zninjamonkey/starting-clamp/BOM.csv

Item | Qty | Supplier | Cost/item | Total Cost | link
PETG filament | 1 | Bambu Lab | $15.99 | $15.99 | https://us.store.bambulab.com/products/petg-translucent?id=42479468281992
Estimated total shipping | 1 |  |  | $7.97
