zninjamonkey/starting-clamp/step/clamp assembly.step

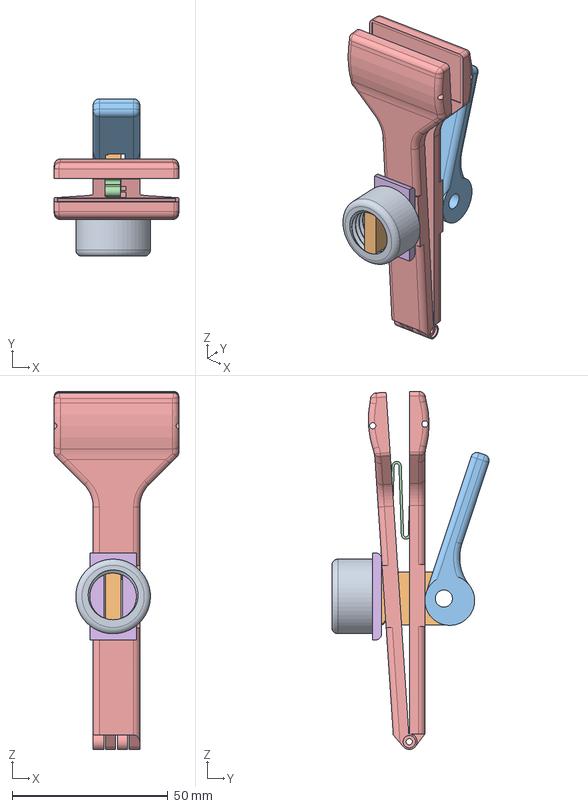
[picture p1: CAD file, 2026-10-17]
step/clamp assembly.step
40.0 x 50.6 x 115.0 mm
