zninjamonkey/starting-clamp/step/clamp spacer.step

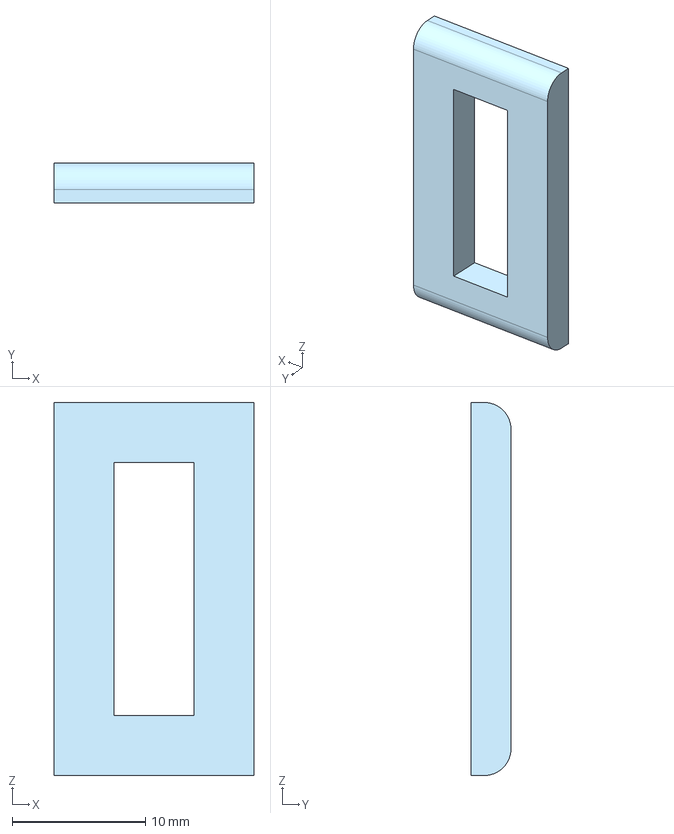
[picture p2: CAD file, 2026-10-17]
step/clamp spacer.step
15.0 x 3.00 x 28.0 mm
