zninjamonkey/starting-clamp/stl/clamp plate.stl

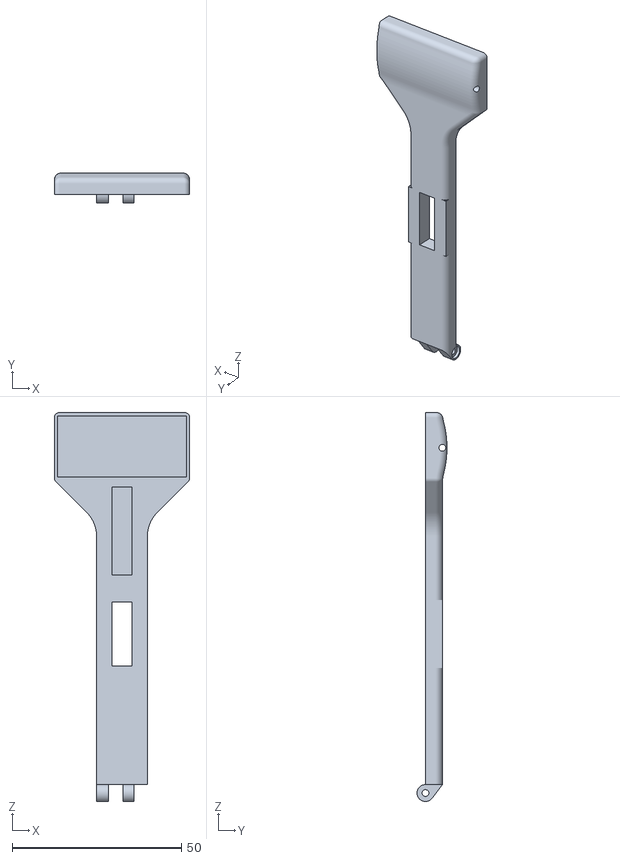
[picture p3: CAD file, 2026-10-18]
stl/clamp plate.stl
40.0 x 8.86 x 115.0
