zninjamonkey/starting-clamp/step/clamp dowel threads.step

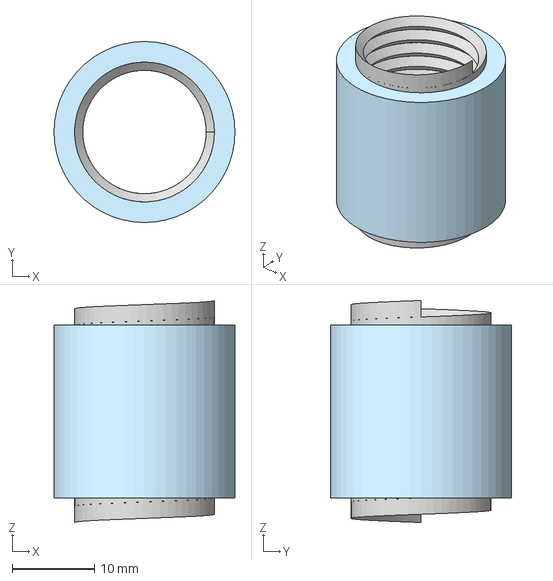
[picture p4: CAD file, 2026-10-17]
step/clamp dowel threads.step
22.0 x 22.0 x 27.0 mm
