zninjamonkey/starting-clamp/step/clamp spring.step

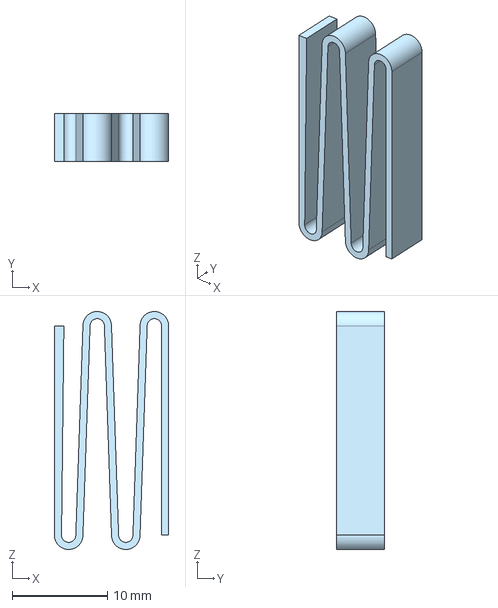
[picture p5: CAD file, 2026-10-17]
step/clamp spring.step
12.0 x 5.00 x 25.0 mm
