zninjamonkey/starting-clamp/step/clamp lever.step

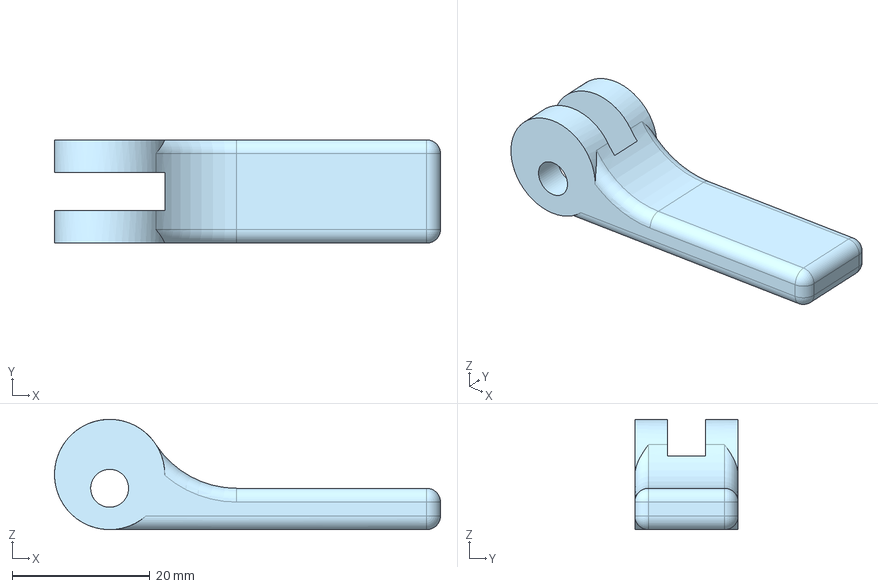
[picture p6: CAD file, 2026-10-17]
step/clamp lever.step
56.0 x 15.0 x 16.0 mm
