zninjamonkey/starting-clamp/step/clamp threaded dowel.step

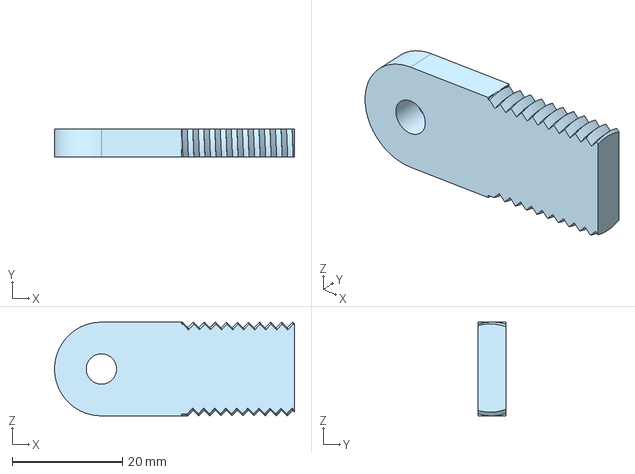
[picture p7: CAD file, 2026-10-17]
step/clamp threaded dowel.step
43.5 x 5.00 x 17.0 mm
