zninjamonkey/starting-clamp/step/clamp knob.step

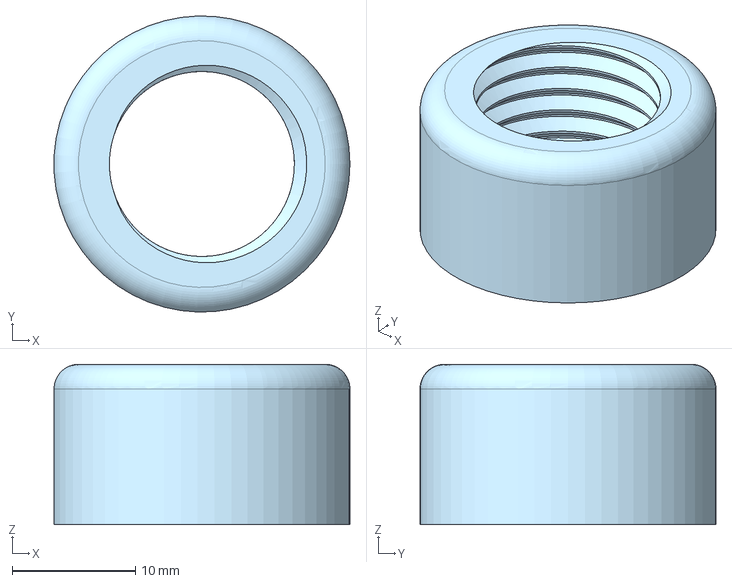
[picture p8: CAD file, 2026-10-17]
step/clamp knob.step
24.0 x 24.0 x 13.0 mm
