zninjamonkey/starting-clamp/(list of files, cad)

Other CAD files:
step/clamping plate.step
parasolid/clamp assembly.x_t
parasolid/clamp dowel threads.x_t
parasolid/clamp knob.x_t
parasolid/clamp lever.x_t
parasolid/clamp spacer.x_t
parasolid/clamp spring.x_t
parasolid/clamp threaded dowel.x_t
parasolid/clamping plate.x_t
stl/clamp knob.stl
stl/clamp lever.stl
stl/clamp spacer.stl
stl/clamp spring.stl
stl/clamp threaded dowel.stl
