zninjamonkey/starting-clamp/JOURNAL.md

# tennis stringing starting clamp tool – devlog

<!-- Generated by Half Life from project cmv686wy70maw01n0k8hcunrl. Edits here are overwritten on the next sync. -->
<!-- Generated: 2026-10-18T02:11:36.854Z -->

> [!NOTE]
> This devlog is mirrored from [Half Life](https://halflife.hackclub.com) – [open the project](https://halflife.hackclub.com/projects/cmv686wy70maw01n0k8hcunrl). Editing it here will not change the platform's copy, and the next sync overwrites this file.

> a 3d printed clamp that you use to start tensioning the strings on a tennis racket

| Week | Tier | Hours logged | Entries |
| --- | --- | --- | --- |
| Week 2 | Tier 1 | 11h | 4 |

## Contents

1. [2026-10-14 – ## Began CADing for Starting Clamp Project](#2026-10-14-began-cading-for-starting-clamp-project)
2. [2026-10-15 – finished modeling all pieces and started an assembly](#2026-10-15-finished-modeling-all-pieces-and-started-an-assem)
3. [2026-10-17 – Finished assembly and constraints](#2026-10-17-finished-assembly-and-constraints)
4. [2026-10-17 – Finalized project](#2026-10-17-finalized-project)

## Design

### 2026-10-14 – ## Began CADing for Starting Clamp Project

**4.5h**

## Began CADing for Starting Clamp Project

journaling for 4.5 hours total, across two days

I got some solid work done on my tennis starting my clamp project.

Since I was inspired and impressed by [this](https://www.thingiverse.com/thing:4597862) 3d printed flying clamp I found on thingiverse, my design is following its core mechanism for firmly clamping a tennis string against a force that could be up to 60 lbs.

Basically all starting clamps you can buy have the same basic design, spring loaded plier handles connected to textured, high friction plates that squeeze the string to hold it in place while tension is pulled. However I'm doing something quite different because It would be practically impossible to 3d print springs that can provide enough clamping force. Also, I think that the overall design is just generally flawed and would be especially bad if it were made with plastic.

My plan is to use a tensioning lever and adjustable knob through two plates that uses the natural flex of plastic to clamp a string with an adjustable level of force. This is how the flying clamps in the link above work. It could be slightly less convinent to have to latch and unlatch the lever whenever you want to clamp, but it should still have all the same capabilites of any other starting clamp and also be less harsh on softer tennis strings.



I began designing one of the plates that will clamp the string. so far I'm assuming that both plates will be identical but I'm not completely sure yet.



it has an area that is inset slightly by 0.2 mm where I will glue a piece of sand paper to provide the nessesary friction on the string where it will clamp.

I have a through hole near the bottom of the handle where I will have the lever and knob mechanism to clamp the plates together. It is closer to the bottom to make better use of the flex of the plastic plates.

there is another inset area near the top that is inset where I will put a simple 3d printed square spring to force the plates apart when the lever isn't latched down.



My familiarity with cadding isn't great so I know the sketch was done atrociously, but up to this point, at least everything was fairly straightforward.

The problems began when I decided to attack the screw knob portion

my plan was to create the knob first with the threads on the inside using the helix tool and a sweep, and then use that part with a boolean remove operation to create the corresponding threads on the dowel that connects through the plates. unfortunately I kept getting errors that said the boolean failed to generate valid geometry.




I tried tweaking dimensions to see if that would fix some weird edges that might be causing the failure, but I couldn't figure it out so I ended up making the threads for the dowel first and creating the knob with corresponding internal threads seprately. But this ended up being not the worst because it was easy to create a bit of spacing tolerance on the internal threads of the knob, instead of them just being ideal boolean opposites of each other.



up next I'm going to finalize the exact dimensions of the knob, and design the lever and spring

TLDR; I'm cading a 3d printing a starting clamp for stringing tennis rackets. the design is slightly atypical and based on a flying clamp. so far I've designed the clamping and screwing portions.

### 2026-10-15 – finished modeling all pieces and started an assembly

**3h**

finished modeling all pieces and started an assembly

[Timelapse](https://lookout.hackclub.com/api/media/d20f6d06-d231-4fef-a4b1-6c0b13db2745/video.mp4)

### 2026-10-17 – Finished assembly and constraints

**1.5h**

Finished assembly and constraints

[Timelapse](https://lookout.hackclub.com/api/media/6f5e6fb8-0090-46e3-beb5-f34afcfd0139/video.mp4)

### 2026-10-17 – Finalized project

**2h**

Finalized project

[Timelapse](https://lookout.hackclub.com/api/media/0c74bc9b-e223-4af2-8135-96ae9cc9ce2b/video.mp4)
