zninjamonkey/starting-clamp/(commit log)

2026-10-17 Sync tennis stringing starting clamp tool from Half Life
    [BOM.csv]
2026-10-17 add parasolid cad files
    [clamp assembly.x_t, clamp dowel threads.x_t, clamp knob.x_t, clamp lever.x_t, clamp spacer.x_t, clamp spring.x_t, clamp threaded dowel.x_t, clamping plate.x_t]
2026-10-17 add step cad files
    [clamp assembly.step, clamp dowel threads.step, clamp knob.step, clamp lever.step, clamp spacer.step, clamp spring.step, clamp threaded dowel.step, clamping plate.step]
2026-10-18 Create stl
2026-10-18 add stl models for 3d printing
    [clamp knob.stl, clamp lever.stl, clamp plate.stl, clamp spacer.stl, clamp spring.stl, clamp threaded dowel.stl]
